jcernato/EVSE/3d-teile/kabelquetch.FCStd

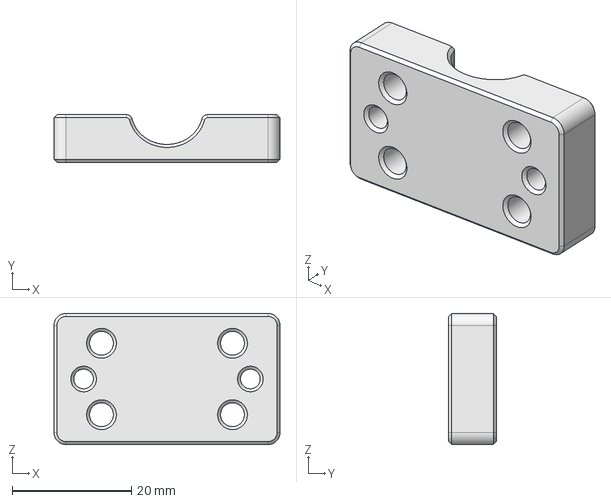
[picture p1: CAD file, 2023-07-01]
3d-teile/kabelquetch.FCStd
38.0 x 8.00 x 22.0 mm
