jcernato/EVSE/3d-teile/Drehknopf.FCStd

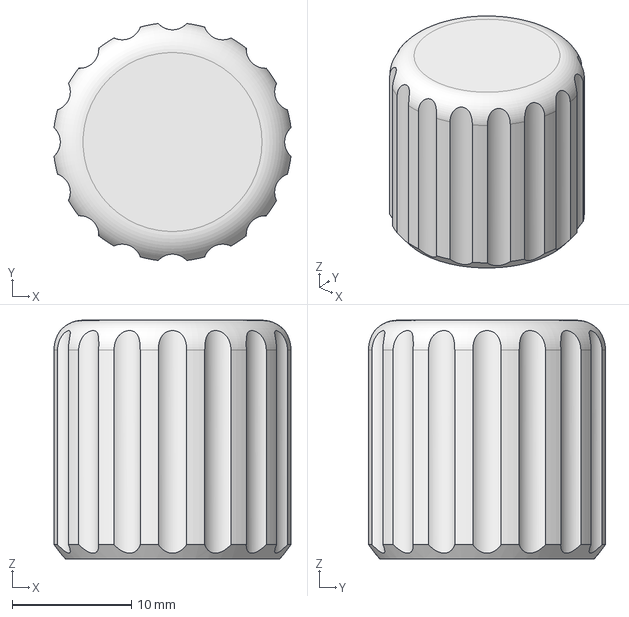
[picture p2: CAD file, 2023-01-20]
3d-teile/Drehknopf.FCStd
19.9 x 19.9 x 20.0 mm
