jcernato/EVSE/kicad/pico_trabenig/pico_trabenig.kicad_pcb

## KiCad design kicad/pico_trabenig/pico_trabenig.kicad_pcb (2023-07-01)

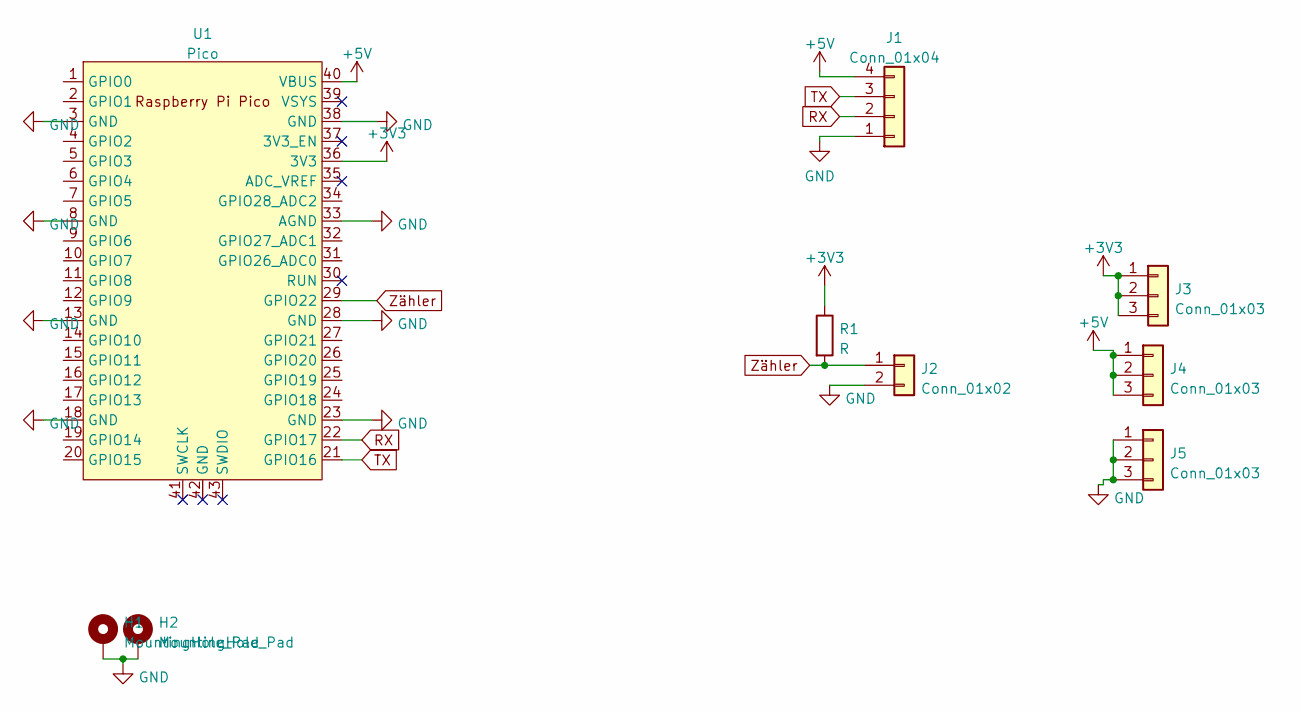
[picture p3: schematic pico_trabenig.kicad_sch]

Parts:
H1, H2: MountingHole_Pad; MountingHole_3.2mm_M3_DIN965_Pad
J1: Conn_01x04; JST_XH_B4B-XH-A_1x04_P2.50mm_Vertical
J2: Conn_01x02; JST_XH_B2B-XH-A_1x02_P2.50mm_Vertical
J3, J4, J5: Conn_01x03; PinSocket_1x03_P2.54mm_Vertical
R1: R; R_1206_3216Metric
U1: Pico; RPi_Pico_SMD_TH

Connections:
+3V3: J3.1, J3.2, J3.3, R1.1, U1.36 (3V3)
+5V: J1.4, J4.1, J4.2, J4.3, U1.40 (VBUS)
GND: H1.1, H2.1, J1.1, J2.2, J5.1, J5.2, J5.3, U1.3 (GND), U1.8 (GND), U1.13 (GND), U1.18 (GND), U1.23 (GND), U1.28 (GND), U1.33 (AGND), U1.38 (GND)
RX: J1.2, U1.22 (GPIO17)
TX: J1.3, U1.21 (GPIO16)
Zähler: J2.1, R1.2, U1.29 (GPIO22)

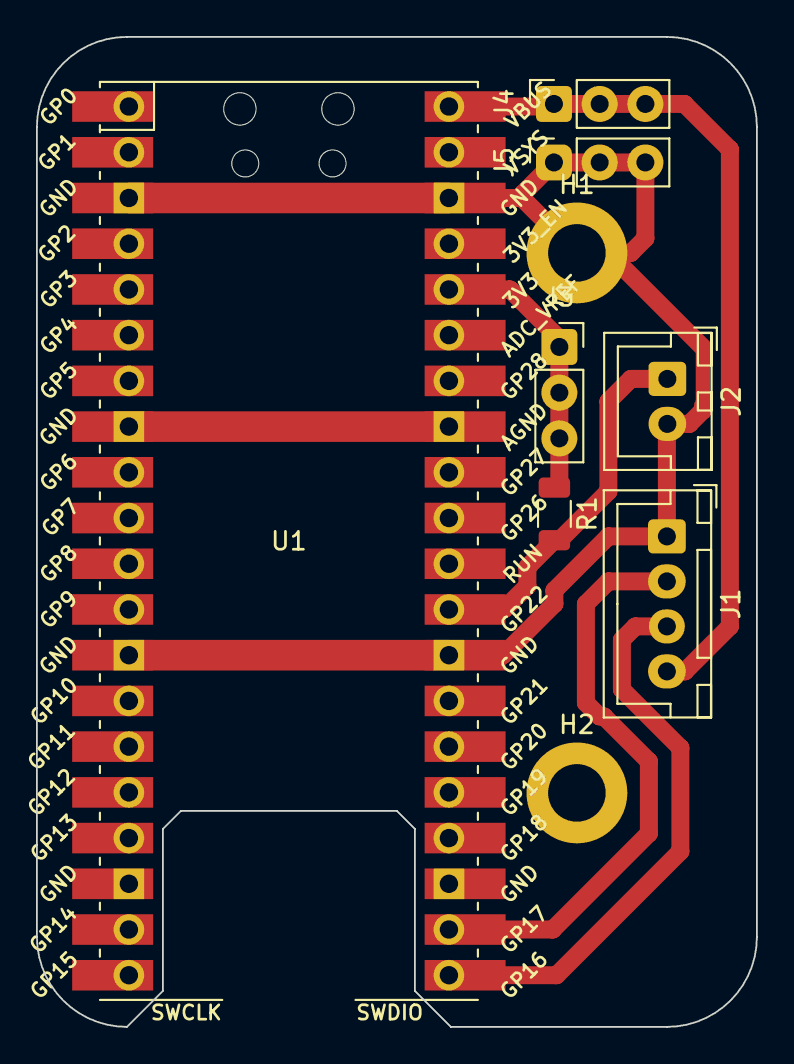
[picture p4: board pico_trabenig.kicad_pcb from above]

Board: 2 copper layers, 40.0 x 55.0 mm, 9 parts (0 on the bottom side), 6 nets.
