jcernato/EVSE/kicad/board/USB-UART/USB-UART.kicad_pcb

## KiCad design kicad/board/USB-UART/USB-UART.kicad_pcb (2023-02-15)

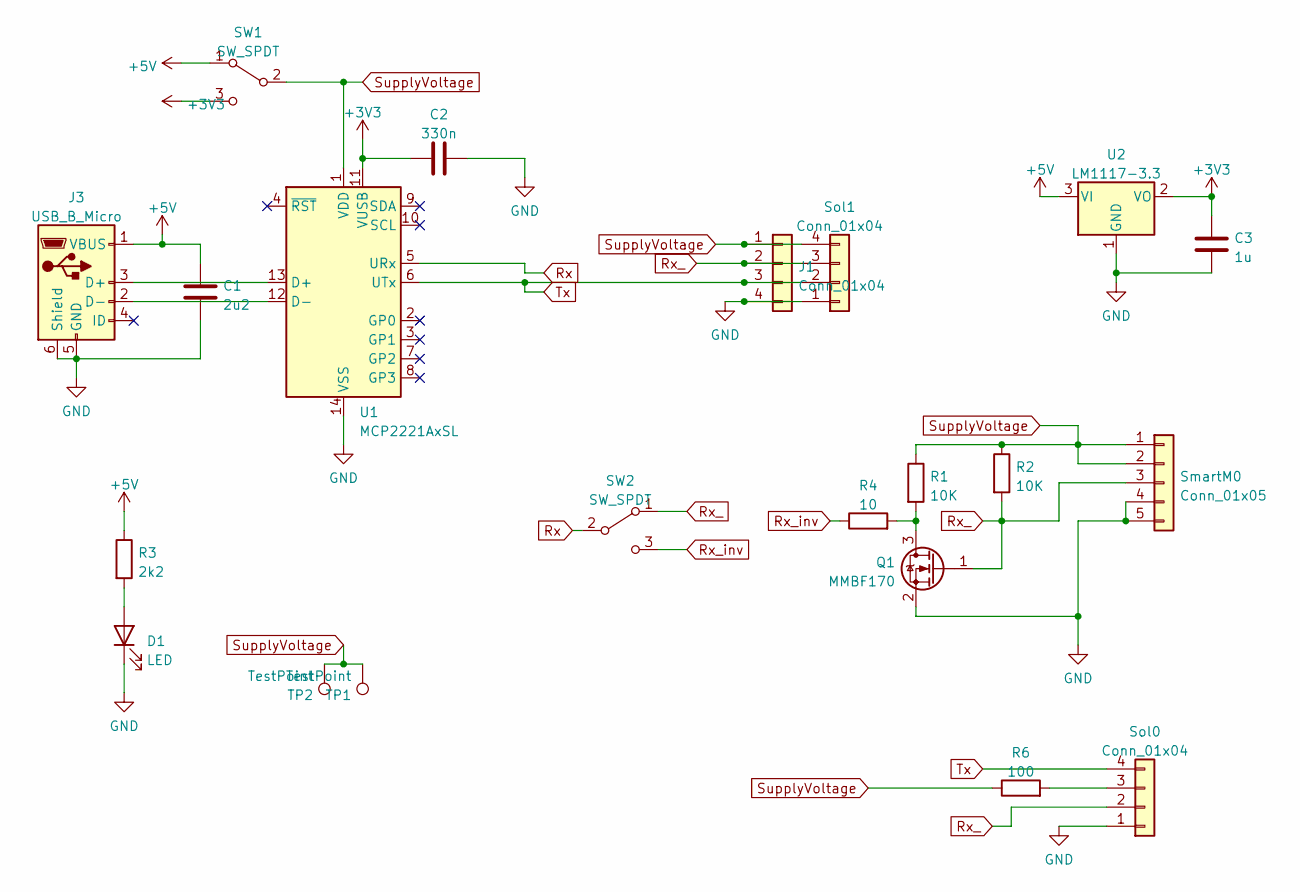
[picture p5: schematic USB-UART.kicad_sch]

Parts:
C1: 2u2; C_Radial_D5.0mm_H5.0mm_P2.00mm
C2: 330n; C_1206_3216Metric
C3: 1u; C_1206_3216Metric
D1: LED; LED_1206_3216Metric
J1: Conn_01x04; Molex_KK-254_AE-6410-04A_1x04_P2.54mm_Vertical
J3: USB_B_Micro; USB_Mini-B_Wuerth_65100516121_Horizontal
Q1: MMBF170; SOT-23
R1, R2: 10K; R_1206_3216Metric
R3: 2k2; R_1206_3216Metric
R4: 10; R_1206_3216Metric
R6: 100; R_1206_3216Metric
SW1, SW2: SW_SPDT; SW_Slide_1P2T_CK_OS102011MS2Q
SmartM0: Conn_01x05; JST_PH_B5B-PH-K_1x05_P2.00mm_Vertical
Sol0, Sol1: Conn_01x04; JST_PH_B4B-PH-K_1x04_P2.00mm_Vertical
TP1, TP2: TestPoint; Pin_D1.0mm_L10.0mm
U1: MCP2221AxSL; SOIC-14_3.9x8.7mm_P1.27mm
U2: LM1117-3.3; SOT-223-3_TabPin2

Connections:
+3V3: C2.1, C3.2, SW1.3 (C), U1.11 (VUSB), U2.2 (VO)
+5V: C1.2, J3.1 (VBUS), R3.1, SW1.1 (A), U2.3 (VI)
GND: C1.1, C2.2, C3.1, D1.1 (K), J1.4, J3.5 (GND), J3.6 (Shield), Q1.2 (S), SmartM0.4, SmartM0.5, Sol0.1, Sol1.1, U1.14 (VSS), U2.1 (GND)
unnamed: D1.2 (A), R3.2
unnamed: J3.2 (D-), U1.12 (D-)
unnamed: J3.3 (D+), U1.13 (D+)
unnamed: Q1.3 (D), R1.2, R4.2
unnamed: R6.2, Sol0.3
Rx: SW2.2 (B), U1.5 (URx)
Rx_: J1.2, Q1.1 (G), R2.2, SW2.1 (A), SmartM0.3, Sol0.2, Sol1.3
Rx_inv: R4.1, SW2.3 (C)
SupplyVoltage: J1.1, R1.1, R2.1, R6.1, SW1.2 (B), SmartM0.1, SmartM0.2, Sol1.4, TP1.1, TP2.1, U1.1 (VDD)
Tx: J1.3, Sol0.4, Sol1.2, U1.6 (UTx)

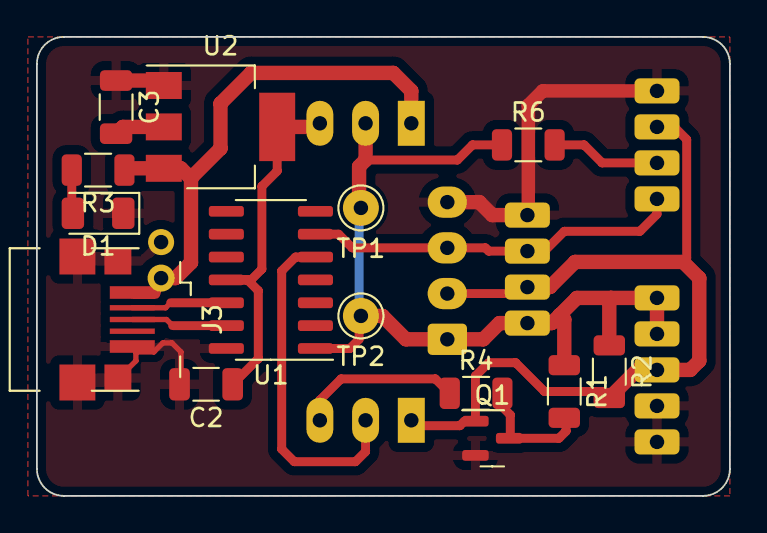
[picture p6: board USB-UART.kicad_pcb from above]

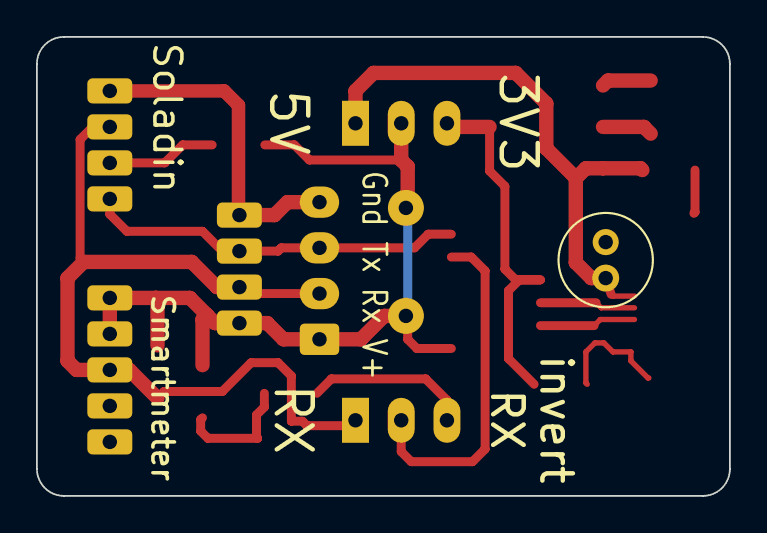
[picture p7: board USB-UART.kicad_pcb from below]

Board: 2 copper layers, 38.5 x 25.5 mm, 21 parts (7 on the bottom side), 13 nets.
