jcernato/EVSE/kicad/board/board.kicad_pcb

## KiCad design kicad/board/board.kicad_pcb (2023-02-15)

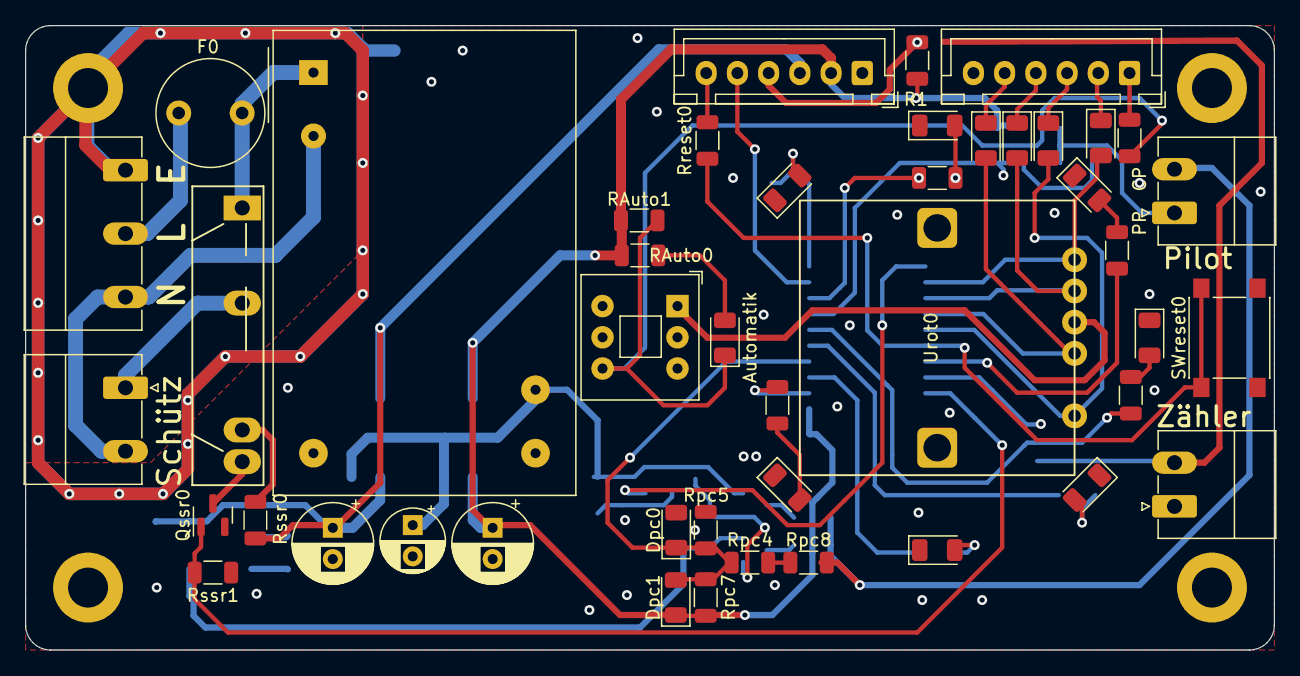
[picture p8: board board.kicad_pcb from above]

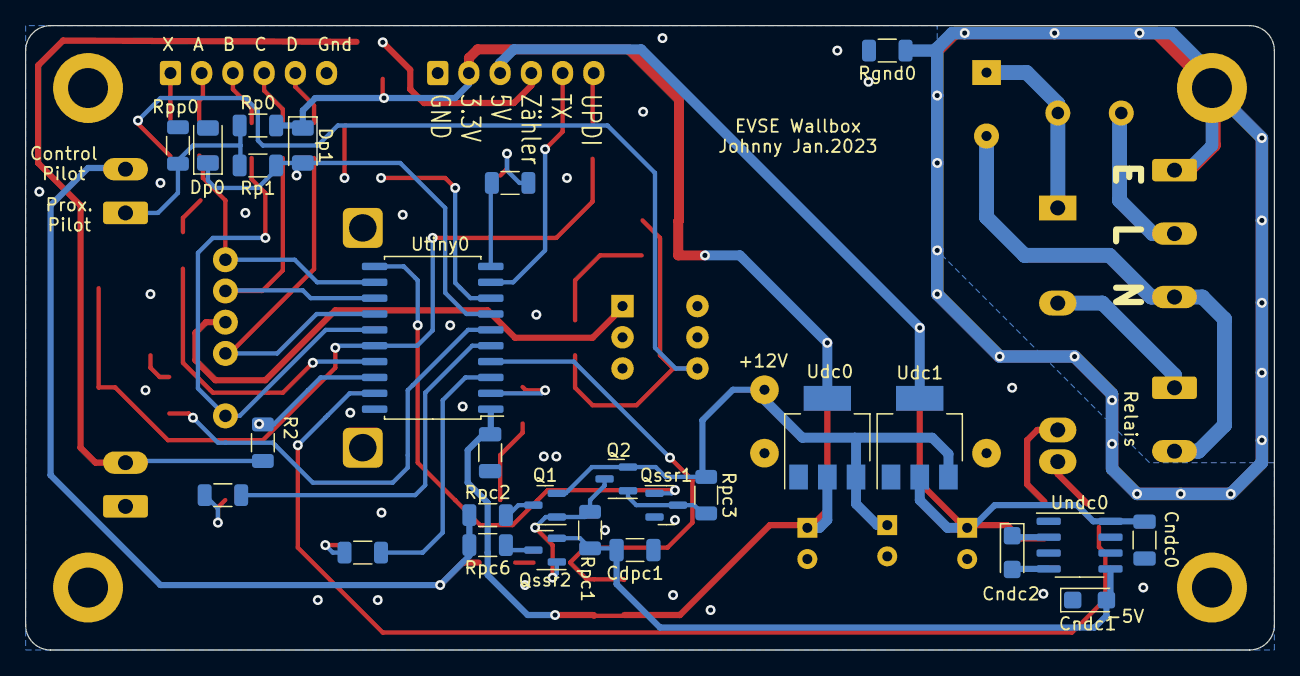
[picture p9: board board.kicad_pcb from below]

Board: 4 copper layers, 100.0 x 50.0 mm, 76 parts (27 on the bottom side), 53 nets.

Parts:
Cd0: 10p; C_1206_3216Metric
Cdc0: 22u; CP_Radial_D5.0mm_P2.50mm
Cdc1, Cdc2: 100u; CP_Radial_D6.3mm_P2.50mm
Cdpc1: 10p; C_1206_3216Metric
Cndc0: 10p; C_1206_3216Metric
Cndc1, Cndc2: 10u; CP_EIA-3216-18_Kemet-A
DLed0, DLed1, DLed2, DLed3, DLed4, DLed5, DLed6: LED; LED_1206_3216Metric
DLed_auto0: LED; LED_1206_3216Metric
Dc0, Dc1, Dc2, Dc3: D; D_1206_3216Metric
Dp0, Dp1: D; D_1206_3216Metric
Dpc0, Dpc1: D; D_1206_3216Metric
F0: 100m; Fuse_Littelfuse_372_D8.50mm
H0, H1, H2, H3: MountingHole_Pad; MountingHole_3.2mm_M3_DIN965_Pad
J0: Netz; PhoenixContact_MC_1,5_3-G-5.08_1x03_P5.08mm_Horizontal
J1: Conn_01x02; PhoenixContact_MC_1,5_2-G-3.5_1x02_P3.50mm_Horizontal
J2: Schütz; PhoenixContact_MC_1,5_2-G-5.08_1x02_P5.08mm_Horizontal
J3: Pilot; PhoenixContact_MC_1,5_2-G-3.5_1x02_P3.50mm_Horizontal
Jcontrol0, Jcontrol1: Conn_01x06; JST_XH_B6B-XH-A_1x06_P2.50mm_Vertical
PSACDC0: IRM-03-12; Converter_ACDC_MeanWell_IRM-03-xx_THT
Q1, Q2: IRLML5203; SOT-23
Qssr0, Qssr1, Qssr2: MMBF170; SOT-23
R1: 10K; R_1206_3216Metric
R2: 1K; R_1206_3216Metric
RAuto0: 1K; R_1206_3216Metric
RAuto1: 100K; R_1206_3216Metric
RAuto2: 10K; R_1206_3216Metric
RLed0, RLed1, RLed2, RLed3, RLed4, RLed5, RLed6: 470; R_1206_3216Metric
Rgnd0: 100; R_1206_3216Metric
Rp0: 3K3; R_1206_3216Metric
Rp1: 4K7; R_1206_3216Metric
Rpc1: 3k3; R_1206_3216Metric
Rpc2, Rpc6: 1K; R_1206_3216Metric
Rpc3: 10k; R_1206_3216Metric
Rpc4, Rpc7, Rpc8: 100K; R_1206_3216Metric
Rpc5: 68K; R_1206_3216Metric
Rpp0: 1K5; R_1206_3216Metric
Rreset0: 4K7; R_1206_3216Metric
Rssr0: 100; R_1206_3216Metric
Rssr1: 10K; R_1206_3216Metric
SWAuto0: SW_Push_DPDT; SW_Push_2P2T_Toggle_CK_PVA2xxH1xxxxxxV2
SWreset0: SW_Push; SW_Push_1P1T_NO_6x6mm_H9.5mm
Udc0: LM1117-3.3; SOT-223-3_TabPin2
Udc1: AZ1117-5.0; SOT-223-3_TabPin2
Undc0: LTC1044; SOIC-8_3.9x4.9mm_P1.27mm
Urot0: PAC18R
Ussr0: S202S01; SIP4_Sharp-SSR_P7.62mm_Straight
Utiny0: ATtiny1616-S; SOIC-20W_7.5x12.8mm_P1.27mm

Connections:
+3V3: Cd0.1, Cdc2.1, Dp1.1 (K), Dpc1.1 (K), Jcontrol1.2, R1.1, RAuto0.2, RAuto1.2, Rp0.2, Rpc7.2, Udc0.2 (VO), Utiny0.1 (VCC)
+5V: Cdc1.1, Cndc0.1, Jcontrol1.3, Rssr0.1, Udc1.2 (VO), Undc0.8 (V+)
+12V: Cdc0.1, PSACDC0.16 (+Vo), Q1.2 (S), Q2.2 (S), Rpc3.1, Udc0.3 (VI), Udc1.3 (VI)
-5V: Cdpc1.2, Cndc1.2, Qssr2.2 (S), Rpc1.2, Undc0.5 (VOUT)
/ACL: F0.1, J0.2
/ACS: J2.1, Ussr0.2
A: Dc3.2 (A), Urot0.1, Utiny0.12 (PC0)
AC: F0.2, PSACDC0.1 (AC/L), Ussr0.1
B: Dc2.2 (A), Urot0.2, Utiny0.15 (PC3)
C: Dc1.2 (A), Urot0.3, Utiny0.13 (PC1)
CP-Read: Dpc0.1 (K), Dpc1.2 (A), Rpc4.1, Rpc5.2, Rpc7.1, Utiny0.4 (PA6)
Control Pilot: J3.2, Rpc2.1, Rpc6.2, Rpc8.2
D: Dc0.2 (A), Urot0.4, Utiny0.14 (PC2)
Earth: H0.1, J0.1, Rgnd0.1
GND: Cd0.2, Cdc0.2, Cdc1.2, Cdc2.2, Cdpc1.1, Cndc0.2, Cndc1.1, DLed0.1 (K), DLed1.1 (K), DLed2.1 (K), DLed3.1 (K), DLed4.1 (K), DLed5.1 (K), DLed6.1 (K), Dp0.2 (A), Dpc0.2 (A), H1.1, H2.1, H3.1, J1.1, Jcontrol0.6, Jcontrol1.1, PSACDC0.14 (-Vo), Qssr0.2 (S), Qssr1.2 (S), Rgnd0.2, Rpc5.1, Rpp0.1, Rssr1.1, SWAuto0.1 (A), SWAuto0.3 (C), SWAuto0.5 (B), SWreset0.2, Udc0.1 (GND), Udc1.1 (GND), Undc0.3 (GND), Urot0.5 (gnd), Utiny0.20 (GND)
Led0: RLed0.1, Utiny0.10 (PB1)
Led1: R2.2, Utiny0.18 (PA2)
Led2: RLed2.1, Utiny0.17 (PA1)
Led3: RLed3.1, Utiny0.6 (PB5)
Led4: RLed4.1, Utiny0.5 (PA7)
Led5: RLed5.1, Utiny0.3 (PA5)
Led6: RLed6.1, Utiny0.2 (PA4)
unnamed: Cndc2.1, Undc0.2 (CAP+)
unnamed: Cndc2.2, Undc0.4 (CAP-)
unnamed: DLed0.2 (A), RLed0.2
unnamed: DLed1.2 (A), J1.2, R2.1, RLed1.2
unnamed: DLed2.2 (A), RLed2.2
unnamed: DLed3.2 (A), RLed3.2
unnamed: DLed4.2 (A), RLed4.2
unnamed: DLed5.2 (A), RLed5.2
unnamed: DLed6.2 (A), RLed6.2
unnamed: DLed_auto0.2 (A), RAuto0.1
unnamed: Dc0.1 (K), Jcontrol0.5
unnamed: Dc1.1 (K), Jcontrol0.4
unnamed: Dc2.1 (K), Jcontrol0.3
unnamed: Dc3.1 (K), Jcontrol0.2
unnamed: Jcontrol0.1, RAuto2.1
unnamed: Q1.1 (G), Q2.3 (D), Qssr2.1 (G), Rpc1.1
unnamed: Q1.3 (D), Rpc2.2
unnamed: Q2.1 (G), Qssr1.3 (D), Rpc3.2
unnamed: Qssr0.3 (D), Ussr0.4
unnamed: Qssr2.3 (D), Rpc6.1
unnamed: Rpc4.2, Rpc8.1
unnamed: Rreset0.1, SWreset0.1, Utiny0.16 (~RESET/PA0)
unnamed: Rssr0.2, Ussr0.3
PP Read: DLed_auto0.1 (K), Dp0.1 (K), Dp1.2 (A), RAuto1.1, RAuto2.2, SWAuto0.6 (C), Utiny0.7 (PB4)
PWM: Qssr1.1 (G), Utiny0.11 (PB0)
Proximity Pilot: J3.1, Rp0.1, Rp1.1, Rpp0.2
Relais: Qssr0.1 (G), Rssr1.2, Utiny0.19 (PA3)
UPDI: Jcontrol1.6, Rreset0.2
Uart_RX: Jcontrol1.4, R1.2, RLed1.1, Utiny0.8 (PB3)
Uart_TX: Jcontrol1.5, Utiny0.9 (PB2)
VAC: J0.3, J2.2, PSACDC0.3 (AC/N)
