jcernato/EVSE/kicad/board/pwm_inverter_test/pwm_inverter_test.kicad_pcb

## KiCad design kicad/board/pwm_inverter_test/pwm_inverter_test.kicad_pcb (2023-01-25)

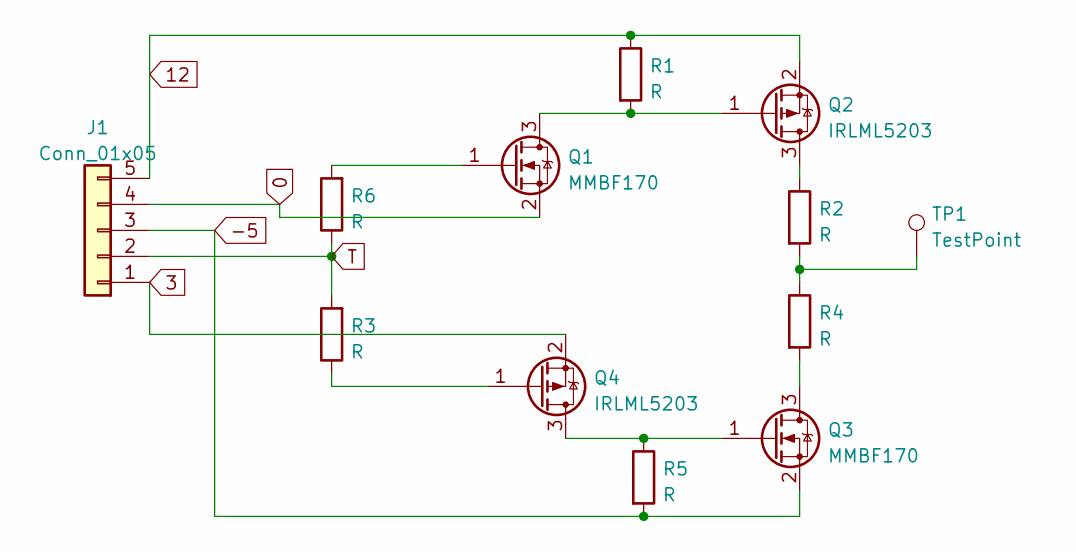
[picture p10: schematic pwm_inverter_test.kicad_sch]

Parts:
J1: Conn_01x05; JST_PH_B5B-PH-K_1x05_P2.00mm_Vertical
Q1, Q3: MMBF170; SOT-23
Q2, Q4: IRLML5203; SOT-23
R1, R2, R3, R4, R5, R6: R; R_1206_3216Metric
TP1: TestPoint; Pin_D0.7mm_L6.5mm_W1.8mm_FlatFork

Connections:
0: J1.4, Q1.2 (S)
3: J1.1, Q4.2 (S)
12: J1.5, Q2.2 (S), R1.1
-5: J1.3, Q3.2 (S), R5.2
unnamed: Q1.3 (D), Q2.1 (G), R1.2
unnamed: Q3.1 (G), Q4.3 (D), R5.1
unnamed: Q4.1 (G), R3.1
unnamed: Q2.3 (D), R2.1
unnamed: R2.2, R4.1, TP1.1
unnamed: Q3.3 (D), R4.2
unnamed: Q1.1 (G), R6.2
T: J1.2, R3.2, R6.1

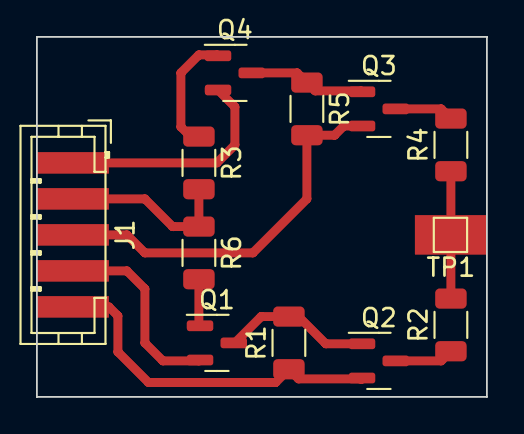
[picture p11: board pwm_inverter_test.kicad_pcb from above]

Board: 2 copper layers, 25.0 x 20.0 mm, 12 parts (0 on the bottom side), 12 nets.
