jcernato/EVSE/firmware/wallbox/src/pinconfig.hpp

#pragma once
#include <Arduino.h>

#define A 10
#define B 13
#define C 11
#define D 12

#define LED12 8
#define LED16 15
#define LED20 14
#define LED24 4
#define LED28 3
#define LED32 1
#define LED36 0

#define RELAIS 16
#define PWM 9
#define CPRead 2
#define AUTOMATIK 5
#define RESET 17
