jcernato/EVSE/firmware/wallbox/src/serial.hpp

#pragma once

#include <Arduino.h>
#include "functions.hpp"
#include "states.hpp"

#define RX_BUFFSIZE 5
void read_serial();

struct _serial_input {
  bool force_auto = false;
  uint16_t wert = 0;
  unsigned long timestamp = 0;
};
extern _serial_input serial_input;
