jcernato/EVSE/(commit log)

2023-01-16 schematic für ersten prototypen fertig
    [board.kicad_pcb, board.kicad_sch]
2023-01-18 Hardware: PCB wie gefräst
    Auf Fräsen optimiert. d.h.:
    -> Vias auf 1.6x1.0 mm vergrößert
    -> An allen Pins die auf Vorderseite angebunden sind Löcher
    vergrößert (für Buchsen)
    Probleme:
    -> Falscher Footprint Solid state relais
    -> Falscher Footprint 100uF Kondensatoren (2x)
    -> Footprint für Drehschalter (PAC18) fehlerhaft
    -> Schaltungsfehler: Drehschalter verhält sich umgekehrt als angenommen
    -> Vorwiderstände für rote LEDs zu hoch
    -> Reset-Knopf ohne Funktion
    -> Spannungsabfall im OPV => PWM -3 ... +10 V
    [board.kicad_pcb, board.kicad_sch]
2023-01-20 firmware: pinconfig und pwm config soweit fertig
2023-01-20 3d-teile: Provisorischen Drehknopf gedruckt
    [Drehknopf.FCStd]
2023-01-25 hardware: kicad board bestellt
    simplifiziert:
    Strom sowie Fehlerstrom werden durch Hauptsicherung und FI gesichert.
    AC-Check is a recht sinnlos weil gegen ein hängendes Relais kannst
    eh nit viel tun.
    Diodencheck macht sinn, wird auch mit -5V statt den Spezifizierten -12V
    duchgeführt, sollt genauso funktionieren, meine LTC1044 halten max 9V aus.
    Rechtck-Puls wird mit Transistor-Brücke realisiert (simuliert, nicht
    getestet). Steigende Flanke wird begrenzt durch pull-down Widerstand
    (auf -5V) und parasitic capazity.
    [board.kicad_pcb, board.kicad_sch, pwm_inverter_test.kicad_pcb, pwm_inverter_test.kicad_sch]
2023-02-01 kicad: USB-UART für Mauki
    [USB-UART.kicad_pcb, USB-UART.kicad_sch]
2023-02-11 firmware: pins an neues pcb angepasst
2023-02-15 hardware: korrekturen fehlerhaftes pcb
    [USB-UART.kicad_pcb, USB-UART.kicad_sch, board.kicad_pcb, board.kicad_sch]
2023-02-15 firmware: Umstellung auf remote via UART
2023-02-24 firmware: Erlaube beliebige Ladeleistung
    Zuvor wurde set_pwm nur mit vordefinierten Ladeleistungen entprechend
    der Encoder-Stellung aufgerufen.
    Im automatik modus kann aber ein arbiträrer Wert zwischen 1000 und 3600
    Watt angegeben werden.
2023-02-25 firmware: großer bugfix
    -> pinconfig - ladeleistung auf 3.4 KW begrenzt
    -> custom classes:
    - erlaube serial input = 0 ohne Fehlermeldung
    - float_buf vergrößert (Angst vor BufferOF)
    - führe automatik als globale Variable
    -> functions:
    - ordendlicher Reset d. PWM Registers (compare match interrupt
    darf nicht auftreten wenn Pin statisch!
    - einige logik Änderungen für "enc = 0" in Abhängigkeit von
    "automatik"
    [functions.h]
2023-02-26 firmware: Umstrukturierung + serielles Protokoll
    Umstrukturiert in header + cpp file
    serielles Protokoll:
    5 Befehle sind definiert:
    L ... setze Ladeleistung
    F ... force automatik modus + setze Ladeleistung
    R ... reset
    V ... sende statusmeldung (ehemalig in main loop)
    S ... Statusmeldung - State, Auto/Man, Checksum
    [functions.cpp, functions.h, wallbox.cpp]
2023-02-26 firmware: bugfix + kosmetik + watchdog
    bug: mit automatik in detected war kein rückstufen in standby möglich
    [_main.py, functions.cpp, functions.h, wallbox.cpp]
2023-03-10 firmware: einige bugfixes + feature (force auto)
    force-auto: force modus bleibt bestehen, kann entweder durch
    'L' command oder durch manuelles drücken des auto-knopfes
    zurückgesetzt werden.
    [functions.cpp]
2023-07-01 save + restore .gitignore
    [board.csv, kabelquetch.FCStd, pico_trabenig.kicad_pcb, pico_trabenig.kicad_sch]
2023-07-03 firmware: code aufteilung in mehrere files
    -> serielle Kommunikation in serial.h/cpp ausgelagert
    -> state class declaration und individuelle set/run funtions in
    states.h/cpp ausgelagert
    code compiliert, nicht getestet!
2023-08-12 firmware: wallbox großes refactoring
    funktionen zerteilt, neue einfache helper hinzugefügt -> code
    leserlicher gemacht
    serielle kommunkation funktioniert, teil reagiert aber auf nix (set
    ladeleistung, encoder, automatik-knopf
2023-08-13 firmware: pico -> umstellung auf mqtt get/set/force
    läuft, aber noch nicht stabil (reagiert nach einiger Zeit nicht mehr)
2023-08-14 firmware: wallbox - umbau update logik
    encoder-led blinkt im auto-modus
    wenn mqtt daten älter als 5 min (out of date) - fallback in
    manuellen modus (ladeleistung gemäß encoder)
    dadurch soll verhindert werden dass nicht geladen wird wenn die
    verbindung zum server ausfällt
2023-08-14 firmware: pico - aufräumen
    viel aufgeräumt und umstrukturiert
    einige verbesserungen bez. zuverlässigkeit:
    -> watchdog integriert
    -> read_serial verbessert (wartet auf fetigen transfer)
    TODO:
    -> mehr resilienz - verbindungsfehler erkennen (mqtt, wlan) und
    wiederherstellen/reboot
    -> LED-indikatoren (mauki) integrieren
    [_main.py]
2023-08-15 firmware: pico + wallbox -> error_code
    error_code eingeführt und als 14. byte in serial-status msg
    integriert.
    error codes:
    0: no error
    1: manual error injected
    2: diode check failed
    3: measurement error
    4: encoder error
    5: set-pwm value error
    [_main.py, functions.cpp, functions.h, serial.cpp, states.cpp, wallbox.cpp]
2023-08-17 firmware: pico - verbindung und wallbox
    wallbox.py beinhaltet wallbox klasse
    verbindung is softlink zu githubs/soladin/software
